FruitLessShip/EE-491-ECE-Capstone-Design-Team-24-KORA-PCB/README.md

# EE-491-ECE-Capstone-Design-Team-24-KORA-PCB
Code, PCB, enclosure, and user manual file repository for ECE capstone design project
