FruitLessShip/EE-491-ECE-Capstone-Design-Team-24-KORA-PCB/Enclosure Middle and Bottom.stl

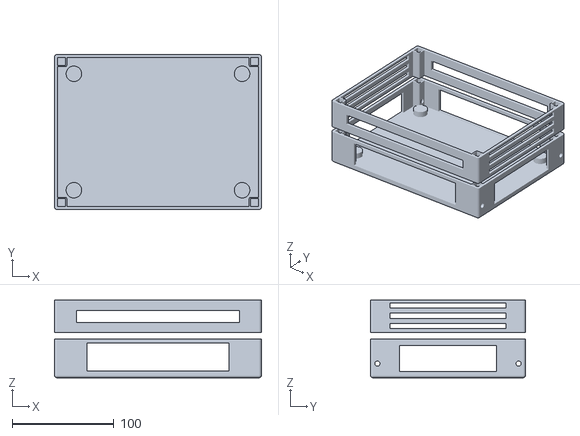
[picture p1: CAD file, 2021-12-01]
Enclosure Middle and Bottom.stl
203.2 x 152.4 x 76.2
