FruitLessShip/EE-491-ECE-Capstone-Design-Team-24-KORA-PCB/Enclosure Top.stl

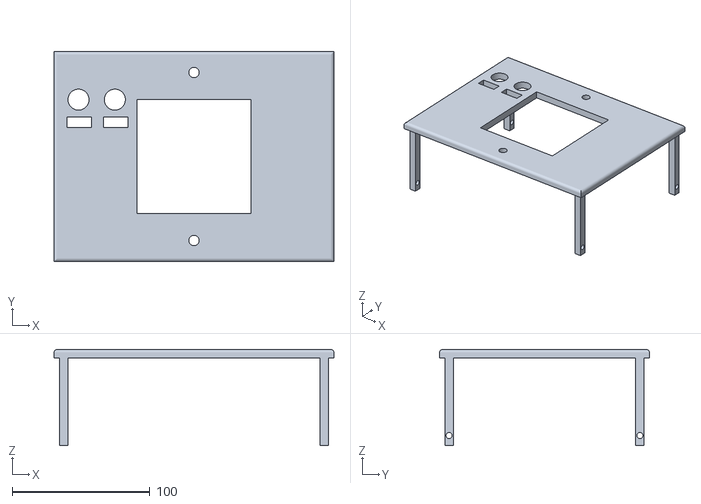
[picture p2: CAD file, 2021-12-01]
Enclosure Top.stl
203.2 x 152.4 x 69.9
