FruitLessShip/EE-491-ECE-Capstone-Design-Team-24-KORA-PCB/(list of files, drawings)

Other design files:
SCH_PCB Schematic_2021-12-08.json
