FruitLessShip/EE-491-ECE-Capstone-Design-Team-24-KORA-PCB/(commit log)

2021-11-21 Add files via upload
    Gerber files for final PCB
2021-12-08 Add files via upload
    Altium PCB file
    [11_11 Edit_2021-12-08.schdoc]
2021-12-08 EasyEDA File
    EasyEDA File
    [SCH_PCB Schematic_2021-12-08.json]
2021-12-08 EasyEDA File
    [SCH_PCB Schematic_2021-12-08.json]
